twoshark/fire-controllers/hardware/v1.0.0/enclosures/mp-input/CAD_NOTES.md

# mp-input — CAD index

**Print two parts:** [`BODY.md`](BODY.md) · [`LID.md`](LID.md).  
XY = **outer base**; sketch → extrude/cut. Workflow: [`../CAD_PARTS.md`](../CAD_PARTS.md).

| Export | Role |
| --- | --- |
| `mp-input-body.stl` | Box · C14/KCD4/M12 · PCB/RS-15 |
| `mp-input-lid.stl` | Lid · triangle + ALL arcade · LED window + dividers |
| `mp-input-led-window.stl` | Clear insert — [`../LED_WINDOW.md`](../LED_WINDOW.md) |

| Dim | mm |
| --- | ---: |
| Outer | **200 × 160 × 90** |
| Inner | **194 × 154 × 84** |
