twoshark/fire-controllers/hardware/v1.0.0/enclosures/mp-output/CAD_NOTES.md

# mp-output — CAD index

**Print two parts:** [`BODY.md`](BODY.md) · [`LID.md`](LID.md).  
XY = **outer base**; sketch → extrude/cut. Kill 12 V: unplug HLG. [`../CAD_PARTS.md`](../CAD_PARTS.md).

| Export | Role |
| --- | --- |
| `mp-output-body.stl` | Box · DTP + M12 + SOL0..2 · PCB |
| `mp-output-lid.stl` | Lid · LED window + dividers (same as sign-output) |
| `mp-output-led-window.stl` | Clear insert — [`../LED_WINDOW.md`](../LED_WINDOW.md) |

| Dim | mm |
| --- | ---: |
| Outer | **220 × 170 × 85** |
| Inner | **214 × 164 × 79** |
