twoshark/fire-controllers/hardware/v1.0.0/enclosures/sign-output/CAD_NOTES.md

# sign-output — CAD index

**Print two parts:** [`BODY.md`](BODY.md) · [`LID.md`](LID.md).  
XY = **outer base**; sketch → extrude/cut. Kill 12 V: unplug HLG. [`../CAD_PARTS.md`](../CAD_PARTS.md).

| Export | Role |
| --- | --- |
| `sign-output-body.stl` | Box · DTP + M12 + SOL0..4 · PCB |
| `sign-output-lid.stl` | Lid · gasket · hinges · LED window + dividers |
| `sign-output-led-window.stl` | Clear insert — [`../LED_WINDOW.md`](../LED_WINDOW.md) |

| Dim | mm |
| --- | ---: |
| Outer | **220 × 170 × 85** |
| Inner | **214 × 164 × 79** |
