twoshark/fire-controllers/hardware/v1.0.0/enclosures/PARTS_BOM.md

# Enclosure parts BOM

Order: [`SHOPPING_LIST.md`](SHOPPING_LIST.md). Cutouts: [`PANEL_CUTOUTS.md`](PANEL_CUTOUTS.md).

## Power

| Use | MPN | Buy | Qty‑1 |
| --- | --- | --- | ---: |
| Input (in box) | RS-15-12 | [Bravo](https://www.bravoelectro.com/rs-15-12.html) | $8.60 |
| Output 12 V (OTS) | HLG-240H-12 | [Bravo](https://www.bravoelectro.com/hlg-240h-12.html) | $71.30 |
| Board feed fuse | ATO **20 A** | [20 pcs](https://www.amazon.com/20pcs-Standard-Fuses-Blade-Automotive/dp/B0CLGTWZHZ) | $4.39/pk |

## Connectors

| Use | Part |
| --- | --- |
| AC IN (inputs) | C14 + rubber cover |
| RS-485 | M12-5 panel + field plug + [dust caps](https://www.amazon.com/Elecbee-Protective-Plastic-Panel-Mount-Sockets/dp/B0B6HYB4KM) |
| 12 V | DTP04-2P (box) / DTP06-2S (HLG) + wedges |
| SOL | DT04-2P / DT06-2S + wedges + cavity plugs |

## Controls

| Item | Notes |
| --- | --- |
| EG STARTS triangle | **owned** · verify Ø for lid holes |
| POWER | KCD4 DPST **IP65** · **inputs only** · AC |
| RESET / BOOT / USB | open lid |

## Seal / mount

| Item | Buy |
| --- | --- |
| Lid gasket · clear LED inserts (print) | foam: [`SHOPPING_LIST.md`](SHOPPING_LIST.md) · CAD [`LED_WINDOW.md`](LED_WINDOW.md) |
| Lid hinge | [bociloy 1"](https://www.amazon.com/bociloy-Cabinet-Rectangle-Stainless-Folding/dp/B0D43MBGXC) ×8 · CAD [`MOUNTING.md`](MOUNTING.md) |
| M2 heat-set + M2 screws | PCB + hinge leaves · **owned** |
| M3 heat-set + M3 screws | front latches + RS-15 feet · **owned** |
| Outdoor SJTW + adhesive HS butt | HLG AC (not inside boxes) · HS **owned** |
| Adhesive HS | HLG DC DTP re-term · **owned** |

## Cables

| Use | Qty | Length |
| --- | ---: | ---: |
| C13–C14 | 2 | 6 ft · **owned** |
| HLG AC SJTW | 2 | 6 ft |
| HLG→DTP | 2 | ≤4 ft · 12 AWG |
| RS-485 | 2 | up to ~30 ft + ~50 ft · KWANGIL 100 ft 9842-equal → M12 |
| SOL internals | — | 18 AWG/ch · star from `J6` |
