twoshark/fire-controllers/hardware/v1.0.0/enclosures/COST_OPTIONS.md

# Cost options

Authoritative cart: [`SHOPPING_LIST.md`](SHOPPING_LIST.md) · audit [`PARTS_REVIEW.md`](PARTS_REVIEW.md) (**~$469** est., 2026-07-18).

| Cart | Ext |
| --- | ---: |
| Bravo RS-15×2 + HLG-240H-12×2 | $159.80 |
| Amazon bociloy 1" hinges 10-pack | $5.29 |
| Lowdoller 2× DTP + 8× DT (+ ship) | $50.00 |
| Cable (KWANGIL + SJTW + 12 AWG) | $185.08 |
| Panel / hardware | $68.64 |
| **Est. sum** | **~$468.81** (+ Lowdoller ship) |

**Owned:** M2/M3 heat-sets + screws · C13–C14 · EG STARTS · adhesive heatshrink.

### Locked decisions

| Choice | Why |
| --- | --- |
| HLG-240H-12 ×2 | 16 A · full PCB headroom |
| DT ×8 · DTP ×2 | Day-1 channels only (5+3) |
| KWANGIL 100 ft | ~30 ft + ~50 ft RS-485 |
| M12 dust caps | Unmated outdoor |

### Add-ons

| ID | Change | Δ | Tradeoff |
| --- | --- | ---: | --- |
| **A** | HangTon USB | +$29 | DFU without opening |
| **C** | TE DT/DTP **flange** panel mounts | +$40–55 | Real panel seal vs printed pocket |
| **G** | One HLG for both outputs | −$71 | Shared 16 A — only if loads never overlap hard |
| **DT expand** | +8 DT kits | +$32 | Panel unused PCB channels later |
| **Belden** | Genuine Belden 9842 | much higher | Brand vs UL equal |

### Do not cut

| Item | Why |
| --- | --- |
| HLG-240H | Outdoor 12 V · 16 A |
| DTP / DT / M12 + caps | Outdoor |
| 120 Ω 2-pair STP | Spec RS-485 |
| SJTW (unless owned outdoor NEMA) | HLG AC |
