twoshark/fire-controllers/hardware/v1.0.0/enclosures/mp-output/PARTS_BOM.md

# mp-output — parts

| Part | Qty |
| --- | ---: |
| Output PCB v1.0.0 | 1 |
| DTP04-2P (12 V IN) | 1 |
| M12-5 + dust cap | 1 |
| DT panel + cable (SOL) | 3 / 3 |
| Shell + lid gasket | 1 |
| HLG-240H-12 (OTS) + DTP pigtail ≤4 ft | 1 |
