twoshark/fire-controllers/hardware/v1.0.0/enclosures/mp-input/PARTS_BOM.md

# mp-input — parts

| Part | Qty |
| --- | ---: |
| Input PCB v1.0.0 | 1 |
| input-buttons daughter PCB | 1 |
| RS-15-12 | 1 |
| EG STARTS triangle | 4 |
| KCD4 + silicone boot | 1 |
| M12-5 + dust cap | 1 |
| IEC C14 + cover | 1 |
| C13–C14 cord 6 ft | 1 |
| Shell + lid gasket | 1 |
