twoshark/fire-controllers/hardware/input-board/bom-jlcpcb.csv

Designator | Quantity | Value | Package | LCSC Part# | MPN | Description | Unit Cost
U1 | 1 | STM32G0B1CBT6 | LQFP-48 | C2847904 | STM32G0B1CBT6 | MCU Cortex-M0+ 64MHz 128KB Flash 36KB SRAM USB DFU | $2.20
U2A,U2B | 2 | SP3485EN-L/TR | SOIC-8 | C8963 | SP3485EN-L/TR | RS-485 transceiver pair for full-duplex (TX path + RX path) | $0.21
U4 | 1 | AP63203WU-7 | TSOT-23-6 | C780769 | AP63203WU-7 | 3.3V buck regulator 2A (12V -> 3.3V) | $0.14
L1 | 1 | 4.7µH | 5.0x5.0mm | C2849485 | PNLS5020-4R7M | Buck power inductor for U4 SW node | $0.05
U5-U6 | 2 | SN74LV14APWR | TSSOP-14 | C7780 | SN74LV14APWR | Hex Schmitt-trigger inverter (2 pcs for 8 channels, logic inverted in firmware) | $0.16
D1 | 1 | SS34 | SMA | C8678 | SS34 | 3A 40V Schottky (reverse polarity protection) | $0.08
D10-D11 | 2 | SM712 | SOT-23 | C521963 | SM712 | Asymmetric TVS diode (one per RS-485 pair) | $0.05
D12 | 1 | USBLC6-2SC6 | SOT-23-6 | C7519 | USBLC6-2SC6 | USB-C D+/D-/VBUS ESD protection array (place at J5) | $0.06
R1-R16,R33 | 17 | 10kΩ 1% | 0603 | C25804 | 0603WAF1002T5E | Input RC/pull-up/BOOT0 pull-down resistors | $0.01
R17-R26 | 10 | 330Ω | 0603 | C23138 | 0603WAF3300T5E | LED current limit (green/yellow) | $0.01
R27 | 1 | 120Ω | 0603 | C22787 | 0603WAF1200T5E | RS-485 RX-pair termination (populated) | $0.01
R28 | 1 | 150Ω | 0603 | C22808 | 0603WAF1500T5E | Blue LED current limit | $0.01
R29-R30 | 2 | 5.1kΩ | 0603 | C23186 | 0603WAF5101T5E | USB-C CC1/CC2 pull-down | $0.01
R31-R32 | 2 | 22Ω | 0603 | C23345 | 0603WAF220JT5E | USB D+/D- series resistors | $0.01
C1 | 1 | 10µF | 0603 | C19702 | CL10A106KP8NNNC | MCU VDD bulk decoupling | $0.02
C2-C7,C20-C27 | 14 | 100nF | 0603 | C14663 | CL10B104KB8NNNC | Decoupling and input RC caps (MCU/RS-485/Schmitt/12V + 8x input RC) | $0.01
C19 | 1 | 100nF | 0603 | C14663 | CL10B104KB8NNNC | Buck bootstrap capacitor (U4.BST to U4.SW) | $0.01
C15,C29,C30,C31,C32 | 5 | 1µF | 0603 | C15849 | CL10A105KB8NNNC | VDDA decoupling (C15) + per-IC 1uF VCC bypass in parallel with 100nF: C29=U2A, C30=U2B (RS-485), C31=U5, C32=U6 (Schmitt) | $0.01
C17 | 1 | 100µF 25V | SMD-6.3x5.4 | C4747964 | RST100UF25V004 | Bulk 12V electrolytic (SMD) | $0.04
C18,C28 | 2 | 22µF 10V | Tantalum-A | C11366 | TAJA226K010RNJ | Buck 3V3 output bulk caps, 2x 22uF per AP63203 datasheet (SMD tantalum) | $0.21
LED1 | 1 | Green | 0603 | C7496818 | F.0603.00025/P2-0603G1TS2-06T-002 | Power indicator LED | $0.01
LED2 | 1 | Blue | 0603 | C7496819 | F.0603.00026/P2-0603B1TS2-06T-001 | Link indicator LED | $0.01
LED3-LED10 | 8 | Yellow | 0603 | C72038 | 19-213/Y2C-CQ2R2L/3T | Channel state LED | $0.03
F1 | 1 | 3A PTC | 1812 | C883162 | BSMD1812-300-16V | 12V input PTC fuse (16V max, 3A hold) | $0.08
SW1-SW2 | 2 | Tactile | SMD | C318884 | TS-1187A-B-A-B | NRST and BOOT0 tactile buttons | $0.05
J1,J3 | 2 | 2-pos 5.08mm | THT | C2915639 | DB128V-5.08-2P-GN-S | Screw terminals: 12V input and input COM/GND | $0.10
J2a,J2b | 2 | 4-pos 5.08mm | THT | C2915641 | DB128V-5.08-4P-GN-S | Screw terminals: CH0-CH3 and CH4-CH7 inputs | $0.15
J4 | 1 | 6-pos 5.08mm | THT | C2915642 | DB128V-5.08-6P-GN-S | Screw terminal: RS485_TX+/TX-/RX+/RX-/GND/SHIELD | $0.22
J5 | 1 | USB-C 16-pin | SMD | C2765186 | TYPE-C-16P-2MD073 | USB-C receptacle (debug port) | $0.07
J6 | 1 | 2x5 1.27mm | SMD | C41376037 | HX-PZ1.27-2x5P-TP | SWD 10-pin debug header | $0.08
