twoshark/fire-controllers/hardware/v1.0.0/input-buttons-pcb/exports/BOM.csv

No. | Quantity | Comment | Designator | Footprint | Value | Manufacturer Part | Manufacturer | Supplier Part | Supplier
1 | 8 | 1N4148W | D1,D2,D3,D4,D5,D6,D7,D8 | SOD-123_L2.8-W1.6-LS3.7-RD |  | 1N4148W | DOWO(东沃) | C22374707 | LCSC
