twoshark/fire-controllers/hardware/v1.0.0/enclosures/mp-output/WIRING.md

# mp-output — wiring

```text
DTP IN → J1     [seat F9]
M12-5 → J2
SOL0..SOL2 (DT) → J6 + J5a
Kill 12 V: unplug HLG-240H-12 AC cord
```

| SOL | OUT |
| --- | --- |
| 0..2 | J5a.1..3 |

Star +12V from both `J6` poles. External DTP from **HLG** · **≤ 4 ft**.
