twoshark/fire-controllers/hardware/v1.0.0/enclosures/mp-input/WIRING.md

# mp-input — wiring

```text
C14 → POWER (KCD4+boot) → RS-15-12 → J1
M12-5 → CN2
Top CH1..CH3 + ALL → J2 / D1..D3
DFU / RESET / BOOT: open lid
```

External: **6 ft** C13→C14.
