twoshark/fire-controllers/hardware/v1.0.0/input-buttons-pcb/exports/gerber/How-to-order-PCB.txt

How to Order PCB

Please refer to:
https://prodocs.easyeda.com/en/pcb/order-order-pcb/index.html
