twoshark/fire-controllers/(commit log)

2026-04-06 docs: design and schematic guide
2026-04-06 docs: schematic guide
2026-04-06 docs: boms
    [bom-jlcpcb.csv]
2026-04-09 feat: full duplex protocol & cleanup
    - Reconcile firmware, hardware BOMs, scripts, and documentation around the STM32G0B1 full-duplex architecture so the repo reflects a single implementation truth and is ready for PCB/layout execution and manufacturing validation.
    - gitignore
    - docs: normalize bom lines and clean current-state wording
    Consolidate duplicate BOM entries into single part-number lines with combined designators and align docs/guides to describe only the current implementation for consistent manufacturing and handoff.
    Made-with: Cursor
    [bom-jlcpcb.csv]
2026-04-09 fix: harden link-health logic and align hardware docs
    Consolidate heartbeat timeout handling into shared protocol constants, improve input-controller link health evaluation, and synchronize BOM/electrical/layout documentation to match corrected parts and full-duplex wiring guidance.
    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
    [bom-jlcpcb.csv]
2026-04-09 docs: finalize hardware appendices and 3V3 buck selection rationale
    Document executable schematic/PCB appendices, refresh part substitutions, and record board-level 3V3 load margins to justify moving from AMS1117 to an in-stock buck path.
    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
    [bom-jlcpcb.csv]
2026-04-09 docs: migrate power docs and BOMs to buck topology
    Replace AMS1117 entries with AP63203WU-7 and add explicit buck support components in both board BOMs. Update schematic and PCB guides/appendices to document SW/BST/inductor network constraints and remove stale LDO-specific layout assumptions.
    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
    [bom-jlcpcb.csv]
2026-04-10 docs: make schematic wiring matrices fully explicit
    Expand schematic guide pages to component-level wiring matrices with concrete designators and verification checks, and align BOM/appendix references for bootstrap caps and terminal/switch/LED wiring details.
    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
    [bom-jlcpcb.csv]
2026-04-10 docs: tighten schematic ground naming and part mappings
    Clarify grounding and channel wiring docs so connector/common references are explicit and unambiguous, while aligning BOM/design docs to the selected Schmitt device and RC capacitor assignments used in the current hardware revision.
    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
    [bom-jlcpcb.csv]
2026-04-12 docs: clarify TVS wiring and correct LED MPN
    Make RS-485 TVS wiring language explicit in the schematic guide and fix the yellow LED MPN typo so both board BOMs match the valid LCSC C72038 part listing.
    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
    [bom-jlcpcb.csv]
2026-04-12 docs: harden output-board specs and layout execution flow
    Resolve output-board documentation ambiguities with explicit designator mappings, corrected channel indexing, and a beginner-safe layout procedure, and add a stock-backed review report with confidence scoring for release readiness.
    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
2026-05-31 docs: clarify output power stage and fix USB ESD wiring
    - Rewrite output Page 5 with explicit low-side topology, per-channel
    diagram, and OUT_CHk (terminal) vs OUT_CHk_SW (drain) net split
    - Fix USBLC6-2SC6 pinout (VBUS is pin 5, not pin 4) on both boards
    - Correct USB ESD clamp ordering: clamp on the connector side of the
    22R series resistors
    - Make J6 a dual-pole 12V_MAIN load feed; document load ground return
    (LOAD_GND_RTN) as internal-only to remove the bypass-the-switch footgun
    - Merge redundant LOAD_12V net into 12V_MAIN throughout
    - Minor consistency: add output C19 to polarity lock list, add
    PA13/SWDIO to output page 2, fix input LED resistor range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
    [bom-jlcpcb.csv]
2026-07-16 Align repo to EasyEDA as-built boards and consolidate hardware docs.
    Replace capture guides with hardware/as-built truth from BOM/PnP/netlist exports, fix input firmware pin map (including EXTI clash on PB0/PB1), and add bring-up/flash scripts for board arrival.
    [BOM_input.csv, BOM_output.csv, PnP_input.csv, PnP_output.csv]
2026-07-16 Rename hardware docs to v1.0.0 and align protocol timing.
    Drop stale JLCPCB BOM folders, retarget CLAUDE/docs to EasyEDA exports,
    and document edge-driven state TX with 25 ms keepalive instead of 1 kHz.
    [BOM_input.csv, BOM_output.csv, PnP_input.csv, PnP_output.csv]
2026-07-16 chore: drop redundant netlist-verified phrasing
    Keep pin-map comments factual and align the bring-up expected RTT log line.
2026-07-16 docs: add sign/mp input enclosure designs and button daughter PCB
    Document IP67 enclosure wiring with AC-hot power switching, Bulgin sealed mains, user arcade buttons, and relocate the ALL FIRE diode-OR exports.
    [BOM.csv, PnP.csv]
2026-07-16 docs: correct enclosure BOM with verified DigiKey SKUs
    Replace wrong PX0580 C14 claim with Buccaneer 400 parts, remove search-only links, and pin qty-1 prices plus selection rationale.
2026-07-16 docs: add output enclosures and budget shopping BOM
    Design sign/mp output boxes with GX16, HangTon lid-closed USB, and
    sized LRS PSUs; relocate EasyEDA exports under input/ and output/.
    [BOM_input.csv, BOM_output.csv, PnP_input.csv, PnP_output.csv]
2026-07-18 docs: lock enclosure BOM to M12 screw-terminal and C14
    Finalize four-box shopping list with exact ASINs/prices, solenoids-only
    outputs, and board/PSU fusing; drop glow and panel-AC-fuse hardware.
2026-07-18 docs: restructure enclosures into six boxes with rated connectors
    Split sign/mp input, output, and output-power into per-box CAD/BOM/wiring.
    Use PanelPole for 12V, AT 2-pin per solenoid, M12 for RS-485 only, and
    document current ratings plus power-box cooling layout.
2026-07-18 docs: lean enclosure cart under $300 with cutouts and cable lengths
    Drop panel RESET/BOOT/USB, switch to DT/Powerwerx/KCD4 pricing, and document PCB keep-outs, panel diameters, and 6 ft AC / ≤4 ft 12 V cables.
2026-07-18 docs: replace PanelPole with DTP and harden outdoor ratings
    Drop AC-rated 12V rockers and Powerwerx PanelPole; use DTP 25A IP67 for the bus, AC kill on power boxes only, and document playa sealing with boots/caps/covers.
2026-07-18 docs: CAD verification — grow boxes, add inserts and mount patterns
    Resize power/output envelopes for LRS and connector pockets, specify M3/M4 heat-set pillars, and document bed/DFM rules for printable shells.
2026-07-18 Add Gerbers and lock PCB mount bosses from drill XY.
    Extract EasyEDA Gerber/Excellon into board export dirs, document the stable 4-hole M2 boss sets, drop printed power boxes for HLG OTS, and re-verify enclosure layouts against outline sizes.
    [Drill_NPTH_Through.DRL, Drill_PTH_Through.DRL, Drill_PTH_Through_Via.DRL, Gerber_BoardOutlineLayer.GKO, Gerber_BottomLayer.GBL, Gerber_BottomSilkscreenLayer.GBO, Gerber_BottomSolderMaskLayer.GBS, Gerber_TopLayer.GTL]
2026-07-18 Harden enclosure power, connector, and seal ratings.
    Document PTC hot derate and load budgets, add Belden/M12 interconnect to the cart, prefer TE DT/DTP with wedges, set F9 to 20 A, and align IP67 claims with playa-practical sealing.
2026-07-18 Lock enclosure CAD mounts, faces, and DFAM clips.
    Shift PCB origins for RS-15 pack, publish boss/lid/arcade XY, put M12 LEFT and DTP BACK for short harnesses, use a compact hex ring on sign-input, and default DT/DTP to separate retainer clips.
2026-07-18 Rebuild enclosure shopping cart with verified links and cheaper parts.
    Drop Quickcar/DryConn premiums, lock HLG-240H and 100ft RS-485, and document internal lid hinges plus M3 heat-set uses.
2026-07-18 Retarget lid hinges for Amazon 1" leaves and document parts review.
    Lock M2 hinge bosses to bociloy pin geometry, keep M3 for latches/RS-15, and record necessity/cost verdicts for the ~$612 cart.
2026-07-18 Drop 8-channel expand buys; size cart for 5+3 SOL.
    Cut DT to eight and DTP to two, switch outdoor PSUs to HLG-185H-12, and sync enclosure docs to day-1 channel counts.
2026-07-18 Remove owned heat-sets, screws, and C13-C14 from the cart.
    Keep outdoor SJTW for HLG AC; drop CNC Kitchen and screw packs now that stock covers mounts.
2026-07-18 Restore HLG-240H-12 outdoor PSUs for 16 A headroom.
    Keep day-1 DT at five plus three; sync power docs and cart totals to the larger Mean Well.
2026-07-18 Mark arcade buttons as owned and drop them from the cart.
2026-07-18 Drop owned heatshrink and re-audit the enclosure cart.
    Session locks stay: HLG-240, day-1 DT 5+3, KWANGIL 100 ft, M12 caps, owned stock out of cart.
2026-07-18 Add per-enclosure BODY and LID CAD build instructions.
    Each of the four boxes now has step-by-step modeling docs for the open-top body and matching lid, plus a shared CAD_PARTS workflow.
2026-07-19 Rewrite enclosure CAD docs with outer XY and sketch/extrude steps.
    BODY and LID instructions now use the outer footprint origin and name each modeling operation explicitly.
2026-07-19 Label every CAD dimension explicitly in millimeters.
    Set document units to mm and suffix sizes, planes, and table headers throughout BODY/LID docs.
2026-07-19 Reverify floor bosses from Gerber drills and tighten CAD coords.
    All four enclosures match drill XY within 0.06 mm; BODY tables now list precise outer mm plus Gerber identities.
2026-07-19 Fix PCB floor-boss transform: use proper CW rotation, not a mirror.
    The old enc_x = ox - Y mapping had Jacobian determinant -1, so bosses could not match an imported board with LEDs facing front. Regenerate all four enclosure boss tables.
2026-07-19 Move LED windows to lids with per-channel dividers and clear prints.
    Board mount is flat (LEDs +Z); FRONT wall cutouts removed; acrylic sheet cut from cart.
2026-07-19 Place PCB LED edge at front of lid so the window clears arcade buttons.
    CW mount puts the LED strip along +X near Y≈35; arcade centers move back.
